brunosmmm/lablight/README.md

lablight
================

Project files for a high power led dimming controller.

Intended use is as lab equipment, for soldering or inspection of small parts.
