brunosmmm/lablight/enclosure/iec.dxf

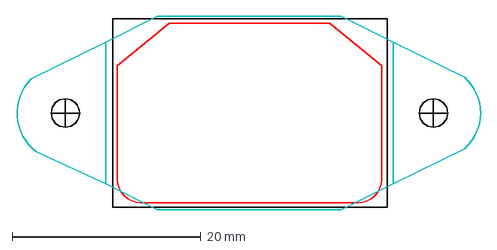
[picture p1: CAD file, 2014-11-12]
enclosure/iec.dxf
49.2 x 20.5 mm
