brunosmmm/lablight/enclosure/panels.dxf

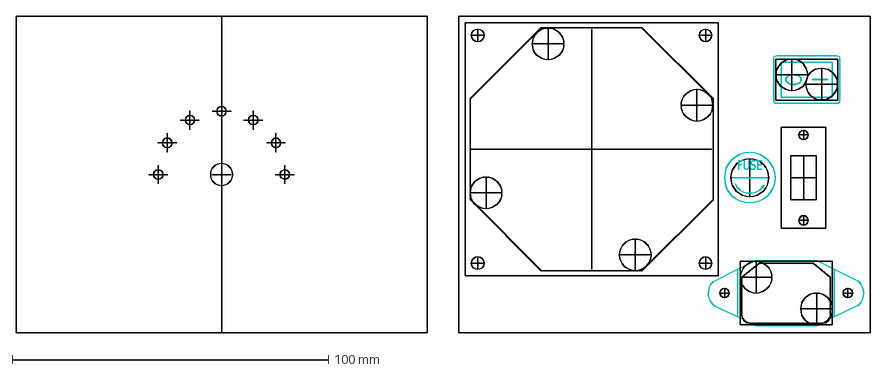
[picture p2: CAD file, 2014-11-12]
enclosure/panels.dxf
I O
FUSE
