brunosmmm/lablight/enclosure/internal.dxf

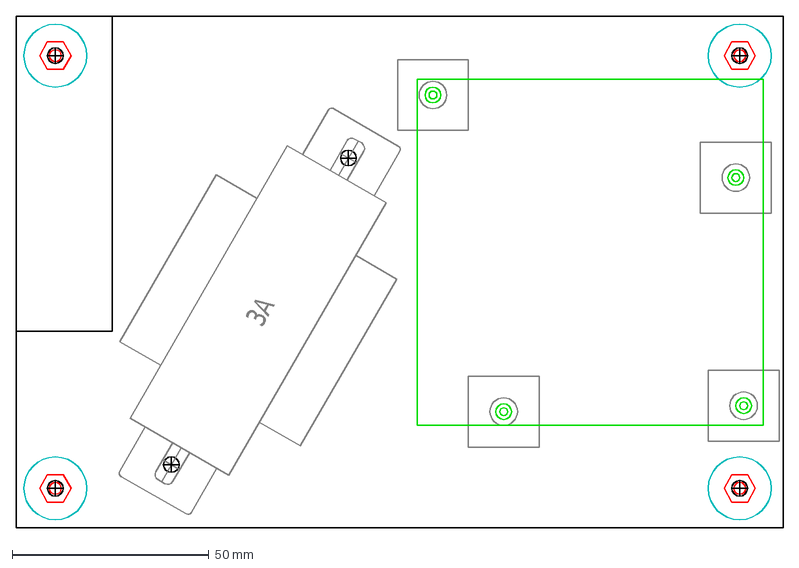
[picture p3: CAD file, 2014-11-12]
enclosure/internal.dxf
3A
