brunosmmm/lablight/enclosure/trafo_3A.dxf

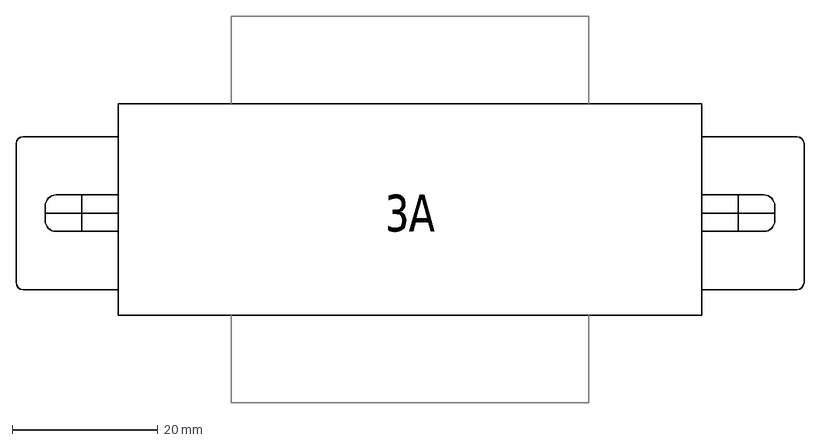
[picture p4: CAD file, 2014-11-12]
enclosure/trafo_3A.dxf
3A
