brunosmmm/lablight/SchemPCB/Controle.sch

## KiCad design SchemPCB/Controle.sch (2014-11-12)

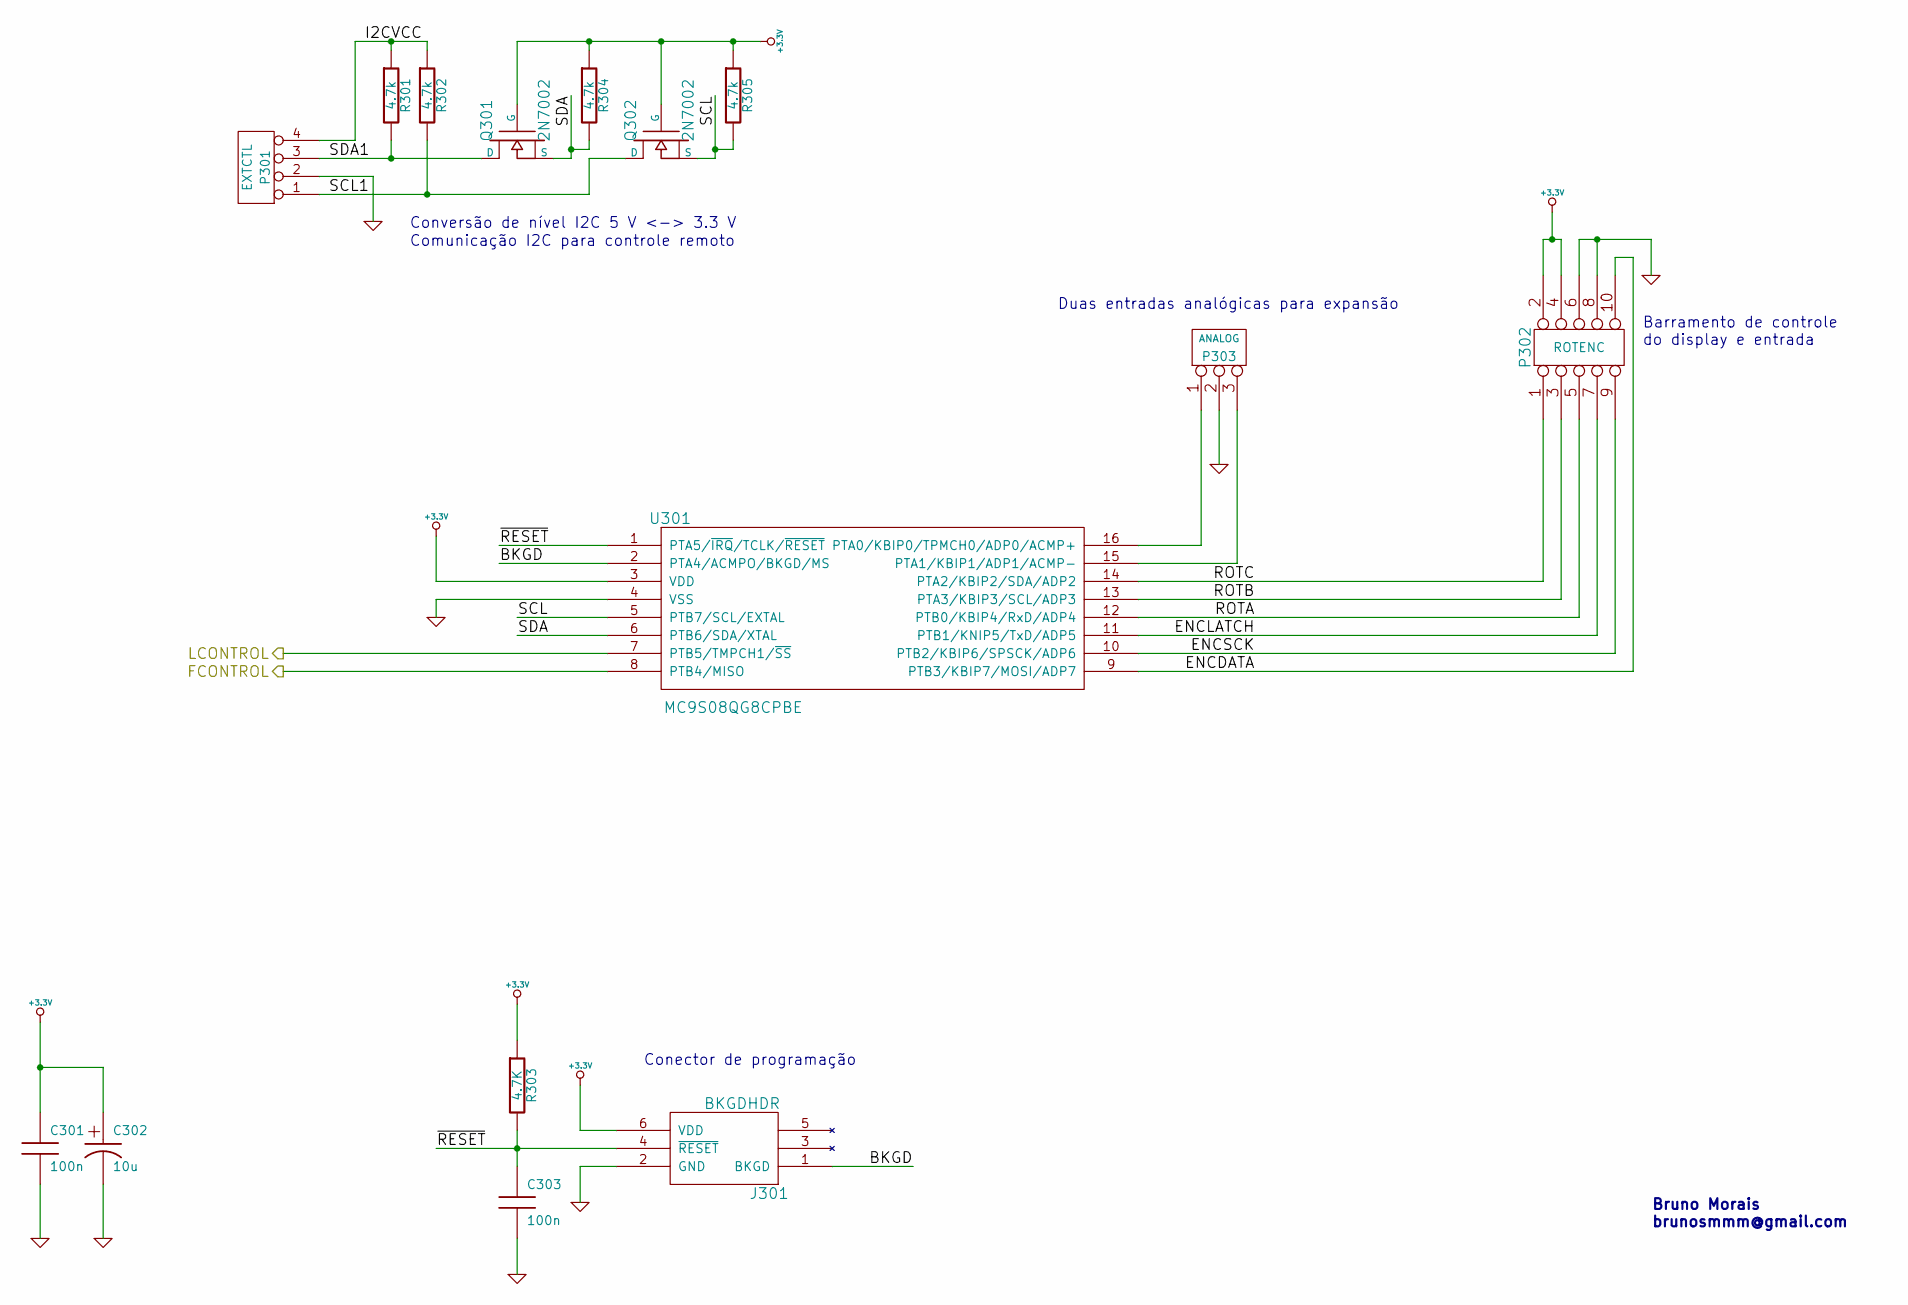
[picture p5: schematic Controle.sch]

Parts:
C301, C303: 100n
C302: 10u
J301: BKGDHDR
P301: EXTCTL
P302: ROTENC
P303: ANALOG
Q301, Q302: 2N7002
R301, R302, R304, R305: 4.7k
R303: 4.7K
U301: MC9S08QG8CPBE

Connections:
+3.3V: C301.1, C302.1, J301.6 (VDD), P302.2, P302.4, Q301.G, Q302.G, R303.1, R304.1, R305.1, U301.3 (VDD)
BKGD: J301.1 (BKGD), U301.2 (PTA4/ACMPO/BKGD/MS)
ENCDATA: P302.10, U301.9 (PTB3/KBIP7/MOSI/ADP7)
ENCLATCH: P302.7, U301.11 (PTB1/KNIP5/TxD/ADP5)
ENCSCK: P302.9, U301.10 (PTB2/KBIP6/SPSCK/ADP6)
FCONTROL: U301.8 (PTB4/MISO)
GND: C301.2, C302.2, C303.2, J301.2 (GND), P301.2, P302.6, P302.8, P303.2 (PM), U301.4 (VSS)
I2CVCC: P301.4, R301.1, R302.1
LCONTROL: U301.7 (PTB5/TMPCH1/~SS)
unnamed: P303.1, U301.16 (PTA0/KBIP0/TPMCH0/ADP0/ACMP+)
unnamed: P303.3, U301.15 (PTA1/KBIP1/ADP1/ACMP-)
ROTA: P302.5, U301.12 (PTB0/KBIP4/RxD/ADP4)
ROTB: P302.3, U301.13 (PTA3/KBIP3/SCL/ADP3)
ROTC: P302.1, U301.14 (PTA2/KBIP2/SDA/ADP2)
SCL: Q302.S, R305.2, U301.5 (PTB7/SCL/EXTAL)
SCL1: P301.1, Q302.D, R302.2
SDA: Q301.S, R304.2, U301.6 (PTB6/SDA/XTAL)
SDA1: P301.3, Q301.D, R301.2
~RESET: C303.1, J301.4 (~RESET), R303.2, U301.1 (PTA5/~IRQ~/TCLK/~RESET)

Notes on the sheet:
Barramento de controle do display e entrada
Comunicação I2C para controle remoto
Conector de programação
Conversão de nível I2C 5 V <-> 3.3 V
Duas entradas analógicas para expansão
Bruno Morais brunosmmm@gmail.com
