brunosmmm/lablight/SchemPCB/Fonte.sch

## KiCad design SchemPCB/Fonte.sch (2014-11-12)

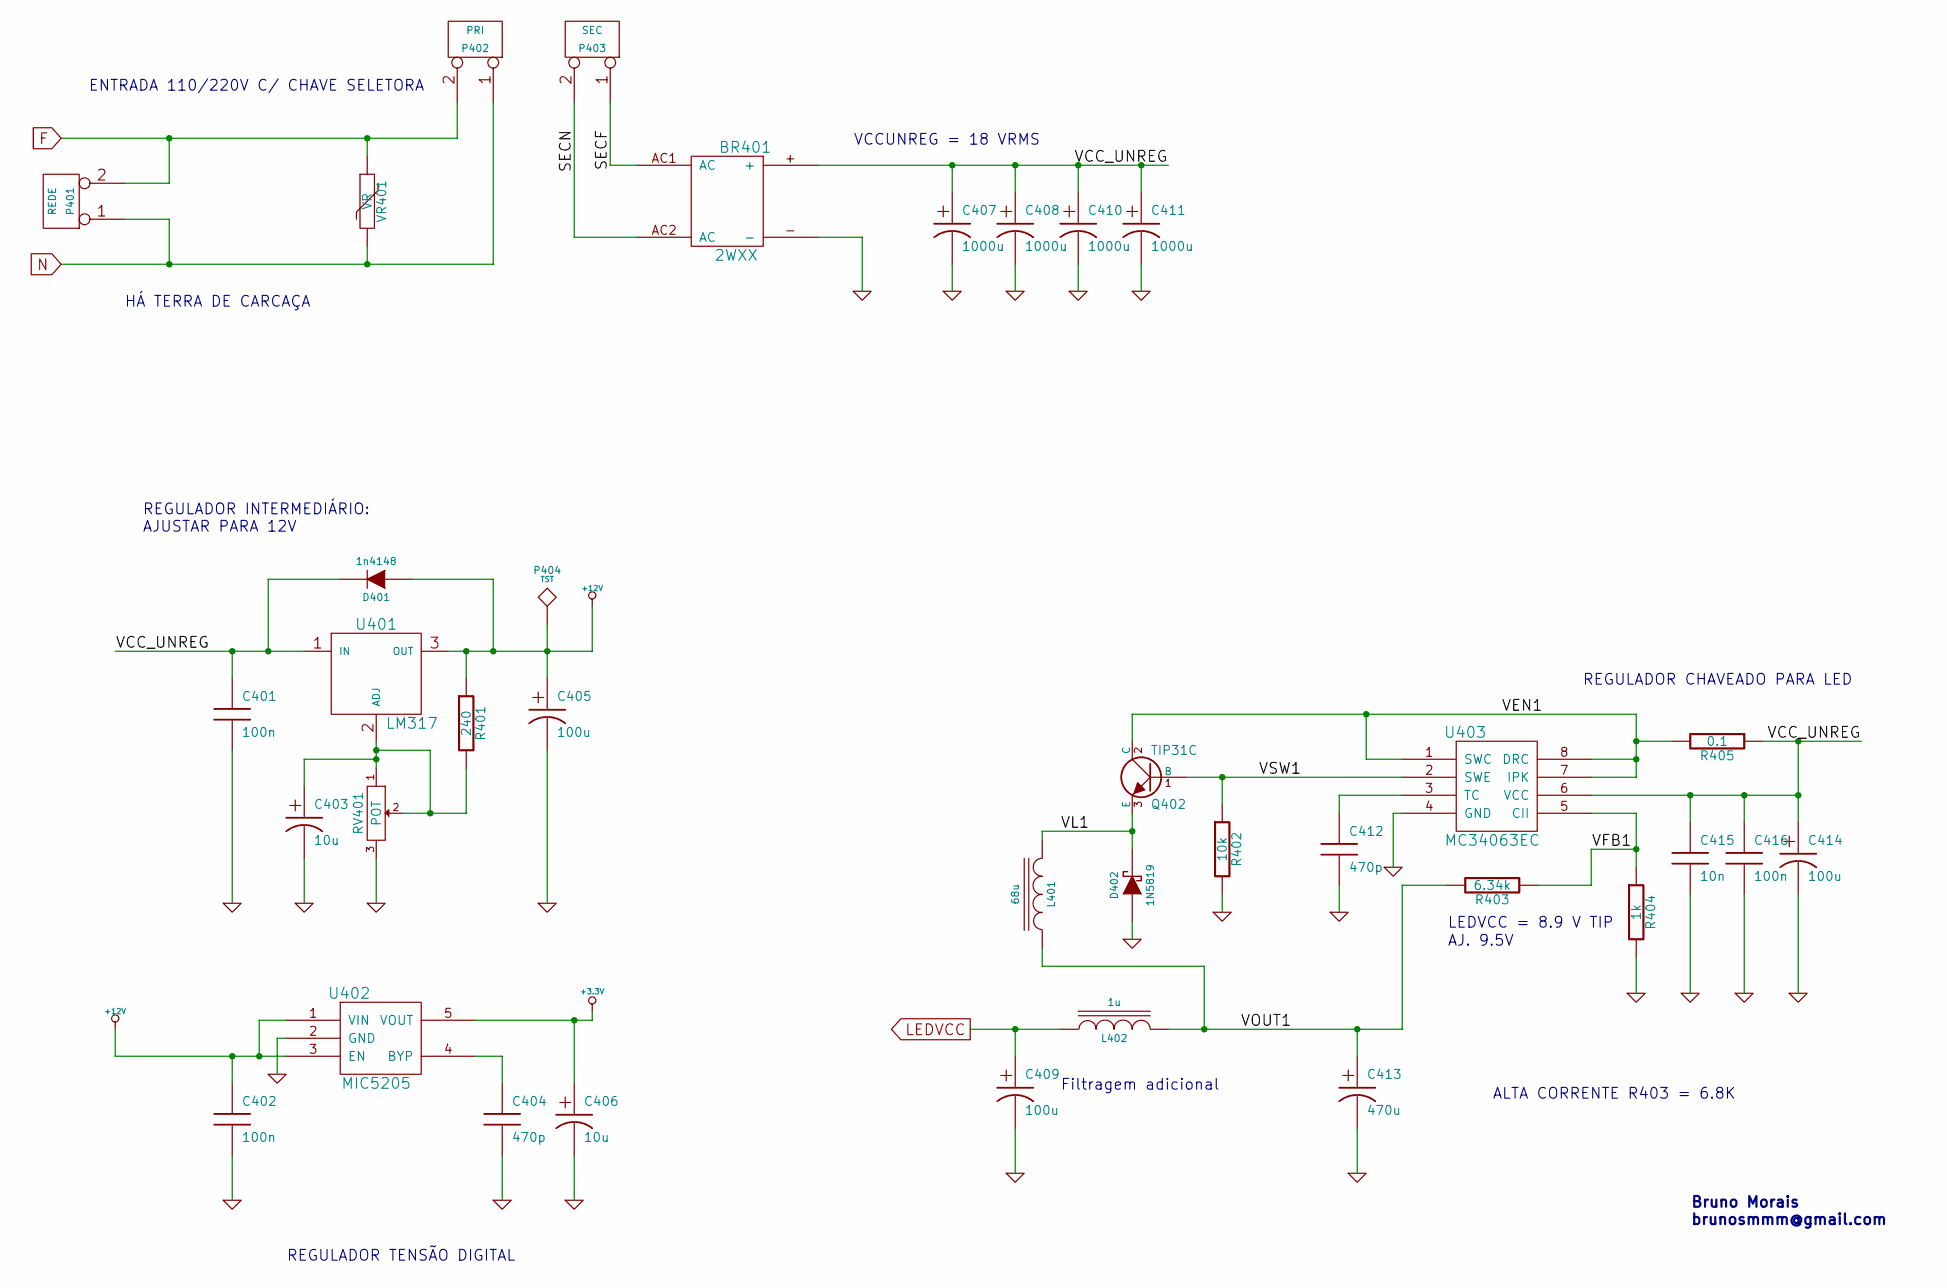
[picture p6: schematic Fonte.sch]

Parts:
BR401: 2WXX
C401, C402, C416: 100n
C403, C406: 10u
C404, C412: 470p
C405, C409, C414: 100u
C407, C408, C410, C411: 1000u
C413: 470u
C415: 10n
D401: 1n4148
D402: 1N5819
L401: 68u
L402: 1u
P401: REDE
P402: PRI
P403: SEC
P404: TST
Q402: TIP31C
R401: 240
R402: 10k
R403: 6.34k
R404: 1k
R405: 0.1
RV401: POT
U401: LM317
U402: MIC5205
U403: MC34063EC
VR401: VR

Connections:
+3.3V: C406.1, U402.5 (VOUT)
+12V: C402.1, C405.1, D401.1 (A), P404.1, R401.1, U401.3 (OUT), U402.1 (VIN), U402.3 (EN)
F: P401.2 (PM), P402.2 (PM), VR401.1
GND: BR401.-, C401.2, C402.2, C403.2, C404.2, C405.2, C406.2, C407.2, C408.2, C409.2, C410.2, C411.2, C412.2, C413.2, C414.2, C415.2, C416.2, D402.1 (A), R402.2, R404.2, RV401.3, U402.2 (GND), U403.4 (GND)
LEDVCC: C409.1, L402.1
N: P401.1, P402.1, VR401.2
unnamed: C403.1, R401.2, RV401.1, RV401.2, U401.2 (ADJ)
unnamed: C404.1, U402.4 (BYP)
unnamed: C412.1, U403.3 (TC)
SECF: BR401.AC1 (AC), P403.1
SECN: BR401.AC2 (AC), P403.2 (PM)
VCC_UNREG: BR401.+, C401.1, C407.1, C408.1, C410.1, C411.1, C414.1, C415.1, C416.1, D401.2 (K), R405.1, U401.1 (IN), U403.6 (VCC)
VEN1: Q402.2 (C), R405.2, U403.1 (SWC), U403.7 (IPK), U403.8 (DRC)
VFB1: R403.1, R404.1, U403.5 (CII)
VL1: D402.2 (K), L401.2, Q402.3 (E)
VOUT1: C413.1, L401.1, L402.2, R403.2
VSW1: Q402.1 (B), R402.1, U403.2 (SWE)

Notes on the sheet:
ALTA CORRENTE R403 = 6.8K
AJ. 9.5V
ENTRADA 110/220V C/ CHAVE SELETORA
HÁ TERRA DE CARCAÇA
VCCUNREG = 18 VRMS
Filtragem adicional
LEDVCC = 8.9 V TIP
Bruno Morais brunosmmm@gmail.com
REGULADOR CHAVEADO PARA LED
REGULADOR TENSÃO DIGITAL
REGULADOR INTERMEDIÁRIO: AJUSTAR PARA 12V
