brunosmmm/lablight/SchemPCB/SecPot.sch

## KiCad design SchemPCB/SecPot.sch (2014-11-12)

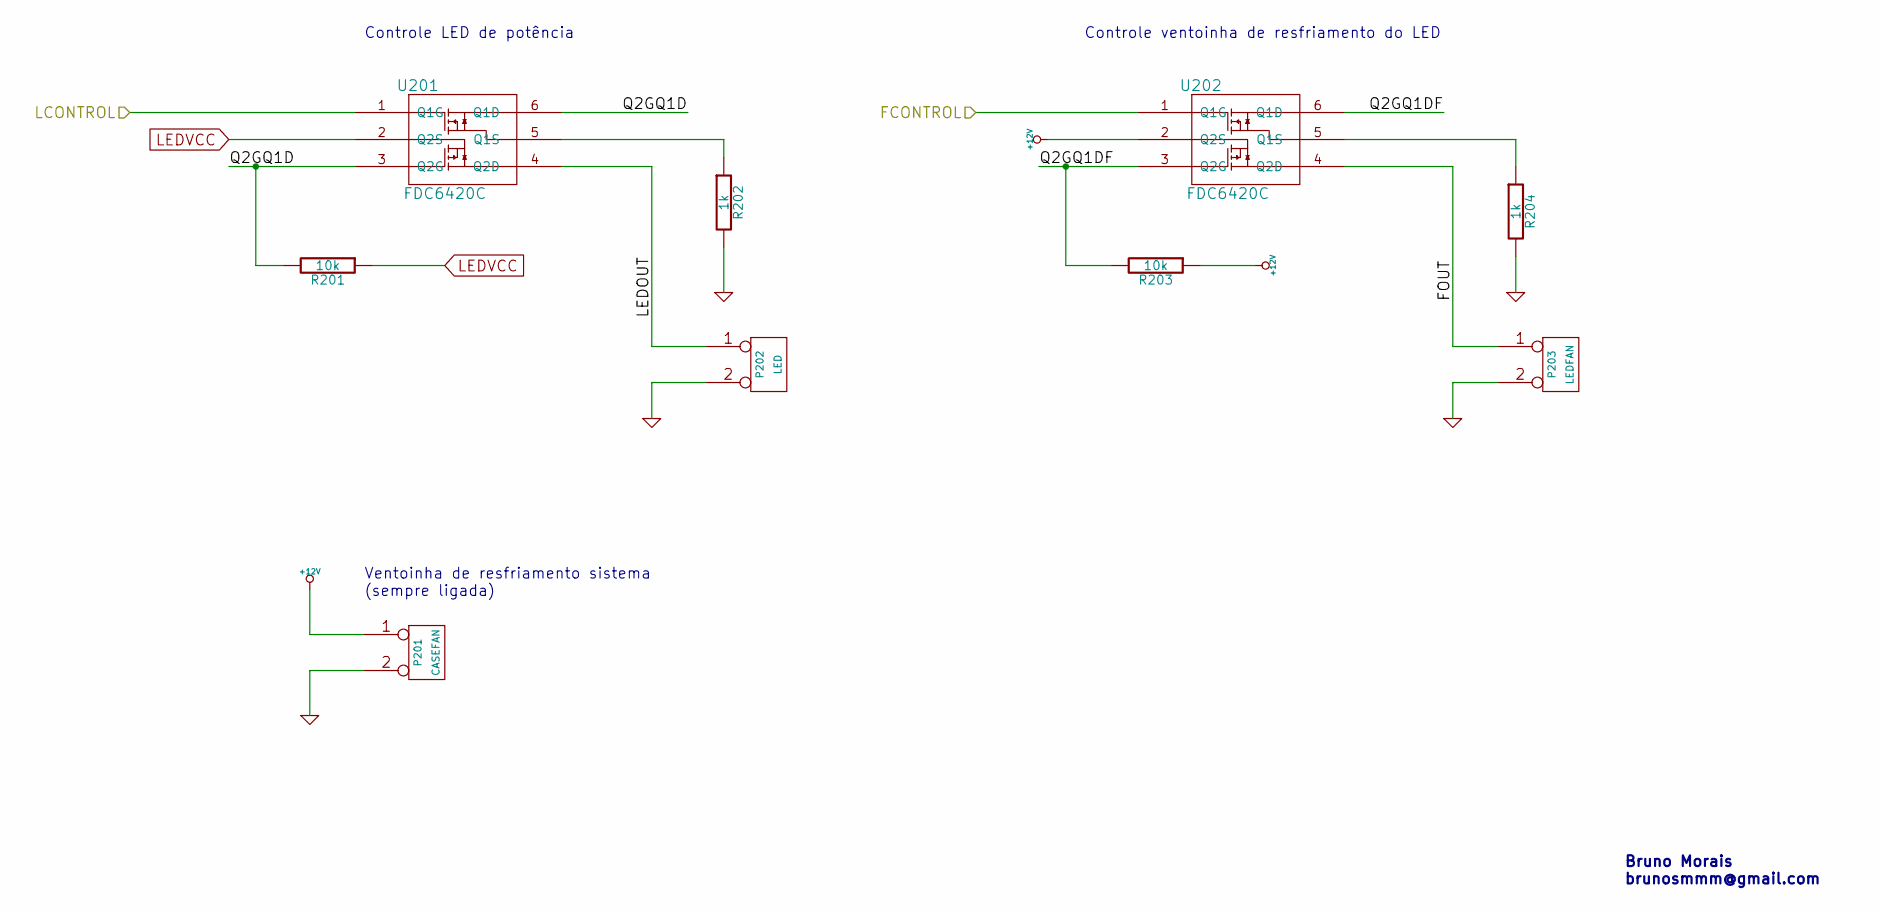
[picture p7: schematic SecPot.sch]

Parts:
P201: CASEFAN
P202: LED
P203: LEDFAN
R201, R203: 10k
R202, R204: 1k
U201, U202: FDC6420C

Connections:
+12V: P201.1, R203.1, U202.2 (Q2S)
FCONTROL: U202.1 (Q1G)
FOUT: P203.1, U202.4 (Q2D)
GND: P201.2 (PM), P202.2 (PM), P203.2 (PM), R202.2, R204.2
LCONTROL: U201.1 (Q1G)
LEDOUT: P202.1, U201.4 (Q2D)
LEDVCC: R201.1, U201.2 (Q2S)
unnamed: R202.1, U201.5 (Q1S)
unnamed: R204.1, U202.5 (Q1S)
Q2GQ1D: R201.2, U201.3 (Q2G), U201.6 (Q1D)
Q2GQ1DF: R203.2, U202.3 (Q2G), U202.6 (Q1D)

Notes on the sheet:
Ventoinha de resfriamento sistema (sempre ligada)
Controle LED de potência
Controle ventoinha de resfriamento do LED
Bruno Morais brunosmmm@gmail.com
