brunosmmm/lablight/SchemPCB/Encoder_LEDS/Encoder_LEDS.sch

## KiCad design SchemPCB/Encoder_LEDS/Encoder_LEDS.sch (2014-11-12)

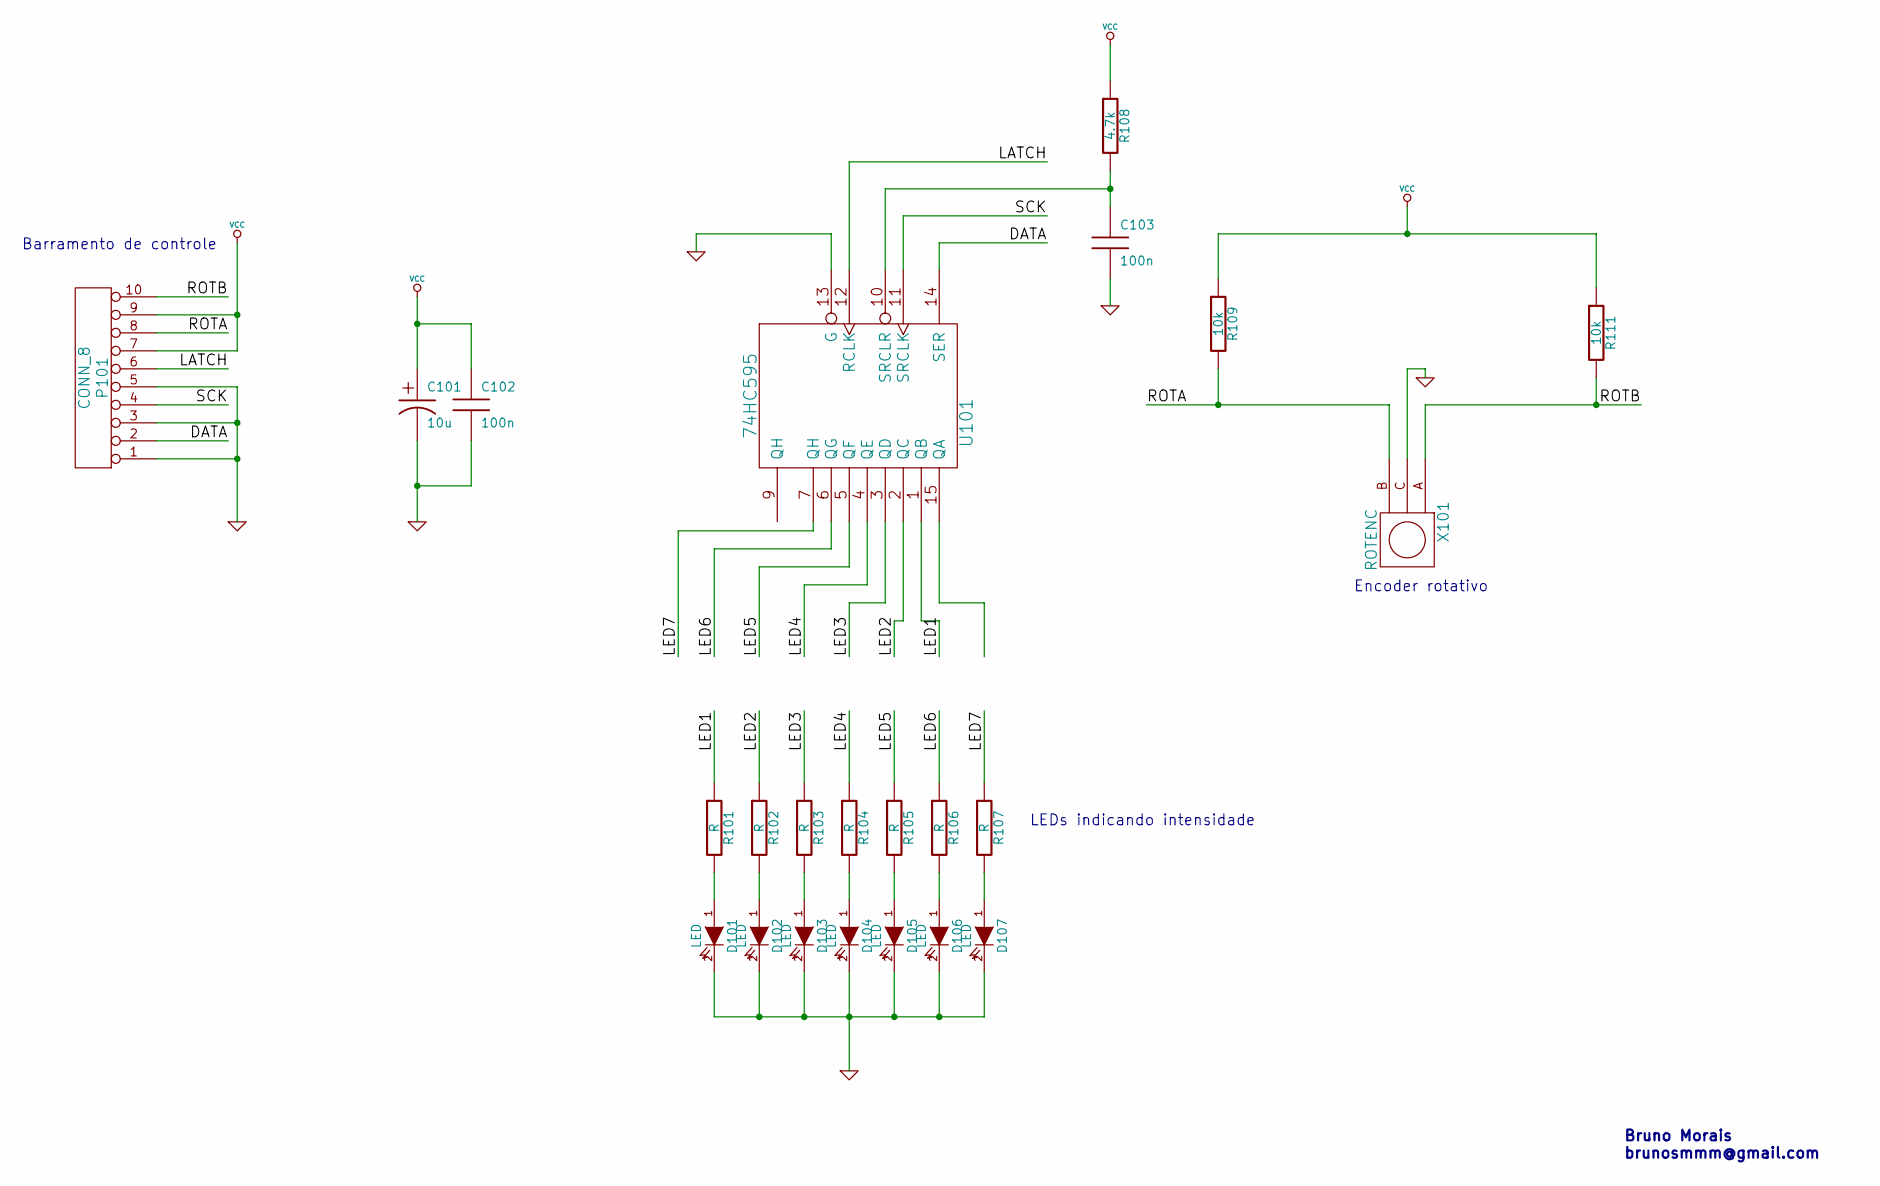
[picture p8: schematic Encoder_LEDS.sch]

Parts:
C101: 10u
C102, C103: 100n
D101, D102, D103, D104, D105, D106, D107: LED
P101: CONN_8
R101, R102, R103, R104, R105, R106, R107: R
R108: 4.7k
R109, R111: 10k
U101: 74HC595
X101: ROTENC

Connections:
DATA: P101.2, U101.14 (SER)
GND: C101.2, C102.2, C103.2, D101.2 (K), D102.2 (K), D103.2 (K), D104.2 (K), D105.2 (K), D106.2 (K), D107.2 (K), P101.1, P101.3, P101.5, U101.13 (G), X101.C
LATCH: P101.6, U101.12 (RCLK)
LED1: R101.1, U101.1 (QB)
LED2: R102.1, U101.2 (QC)
LED3: R103.1, U101.3 (QD)
LED4: R104.1, U101.4 (QE)
LED5: R105.1, U101.5 (QF)
LED6: R106.1, U101.6 (QG)
LED7: R107.1, U101.7 (QH)
unnamed: C103.1, R108.2, U101.10 (SRCLR)
unnamed: D101.1 (A), R101.2
unnamed: D102.1 (A), R102.2
unnamed: D103.1 (A), R103.2
unnamed: D104.1 (A), R104.2
unnamed: D105.1 (A), R105.2
unnamed: D106.1 (A), R106.2
unnamed: D107.1 (A), R107.2
ROTA: P101.8, R109.2, X101.B
ROTB: P101.10, R111.2, X101.A
SCK: P101.4, U101.11 (SRCLK)
VCC: C101.1, C102.1, P101.7, P101.9, R108.1, R109.1, R111.1

Notes on the sheet:
Encoder rotativo
LEDs indicando intensidade
Bruno Morais brunosmmm@gmail.com
Barramento de controle
